HexabitzPlatform/H09R0x-Hardware/README.md

# H09R0x-Hardware
Hexabitz Thermocouple Sensor Module Hardware Design
