HexabitzPlatform/H09R0x-Hardware/Released/3D Models/691311500102/691311500102 (rev1).stp

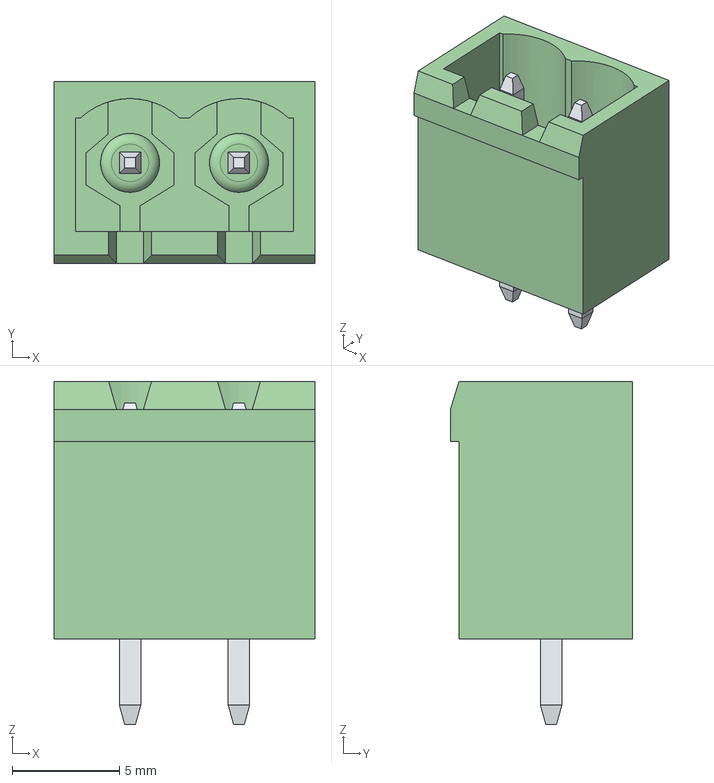
[picture p1: CAD file, 2019-05-23]
Released/3D Models/691311500102/691311500102 (rev1).stp
12.2 x 8.50 x 16.0 mm
6913115001xx_PIN x 2
