HexabitzPlatform/H09R0x-Hardware/Documentation/H09R01 Schematics.pdf

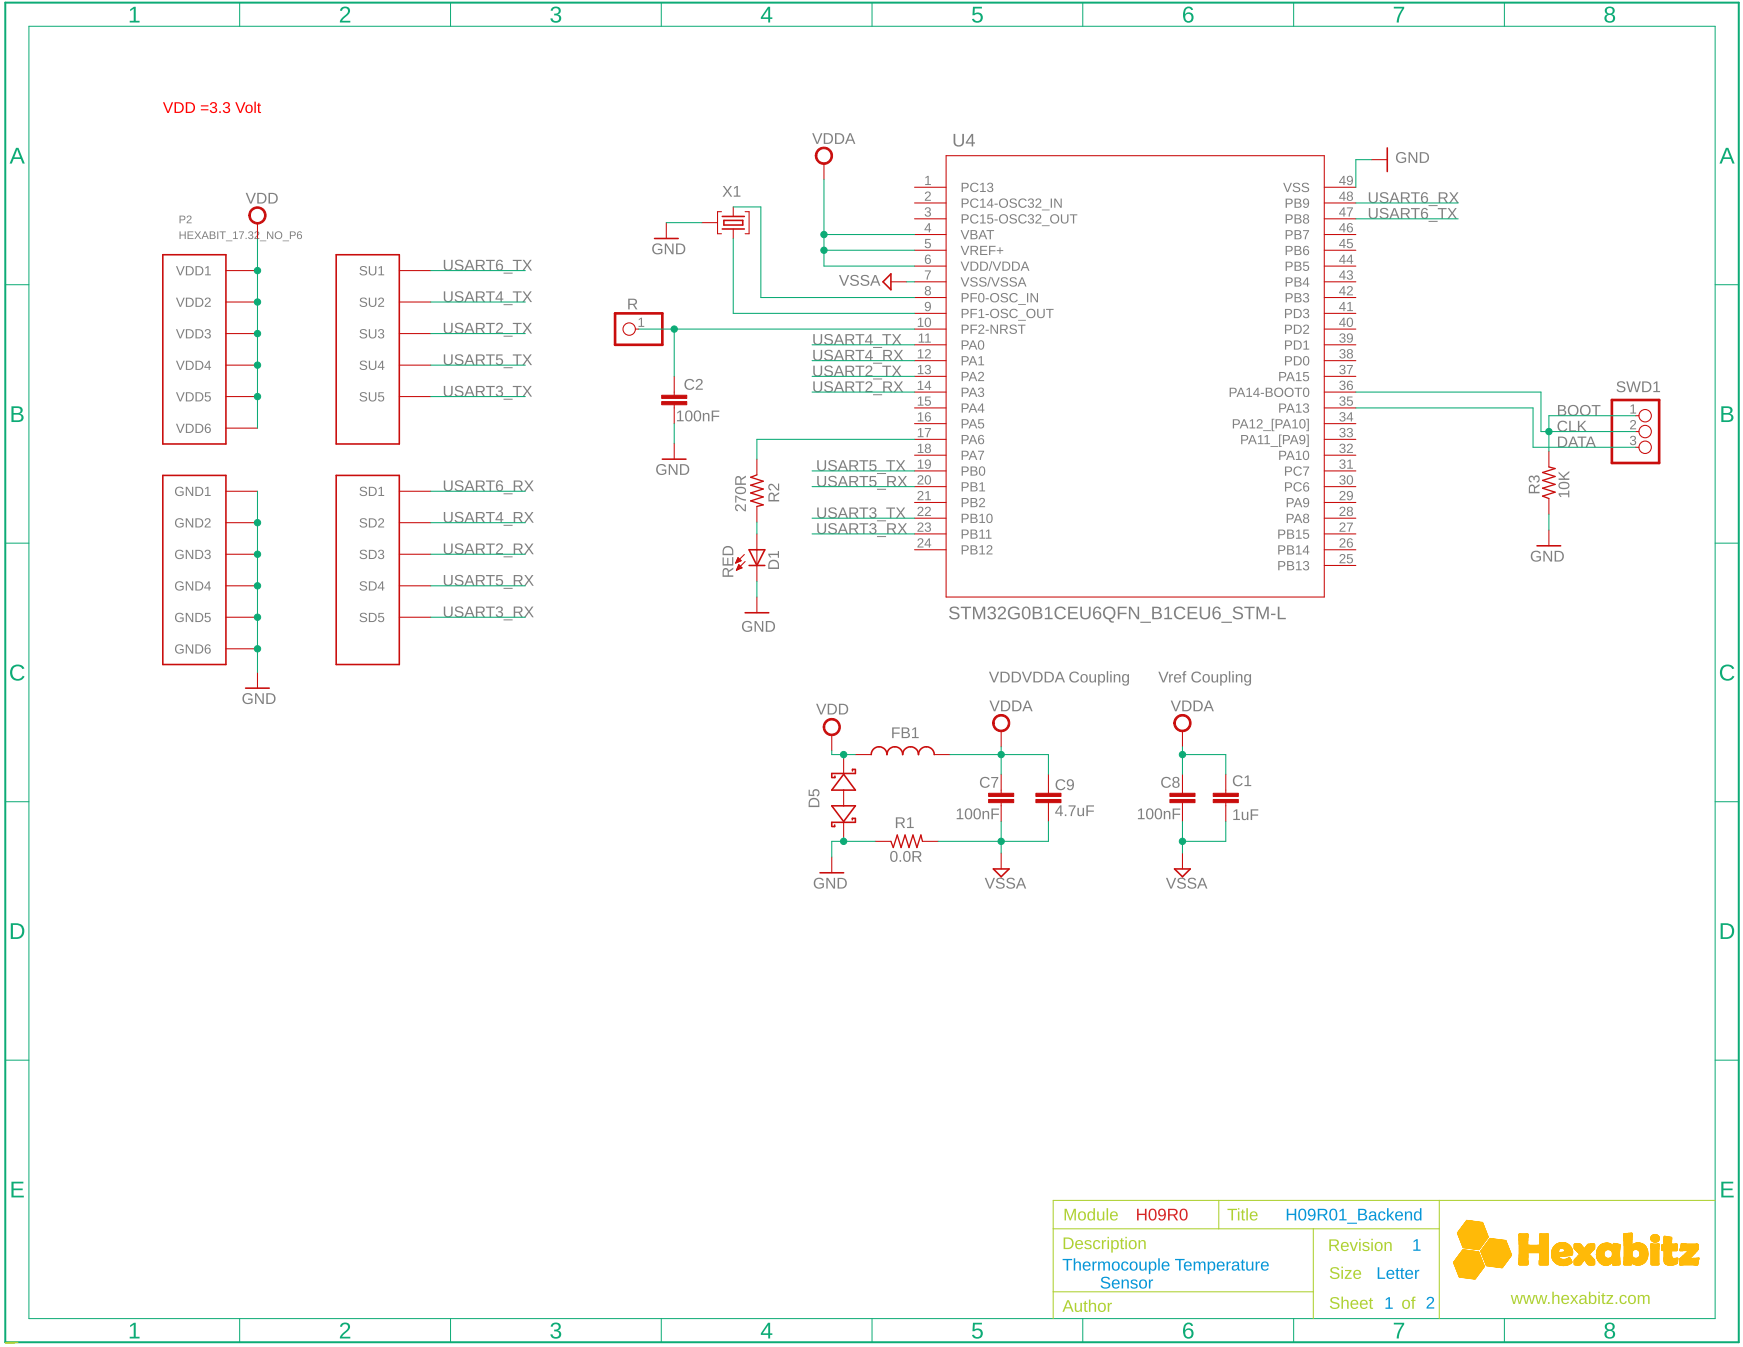
[picture p2: page 1]

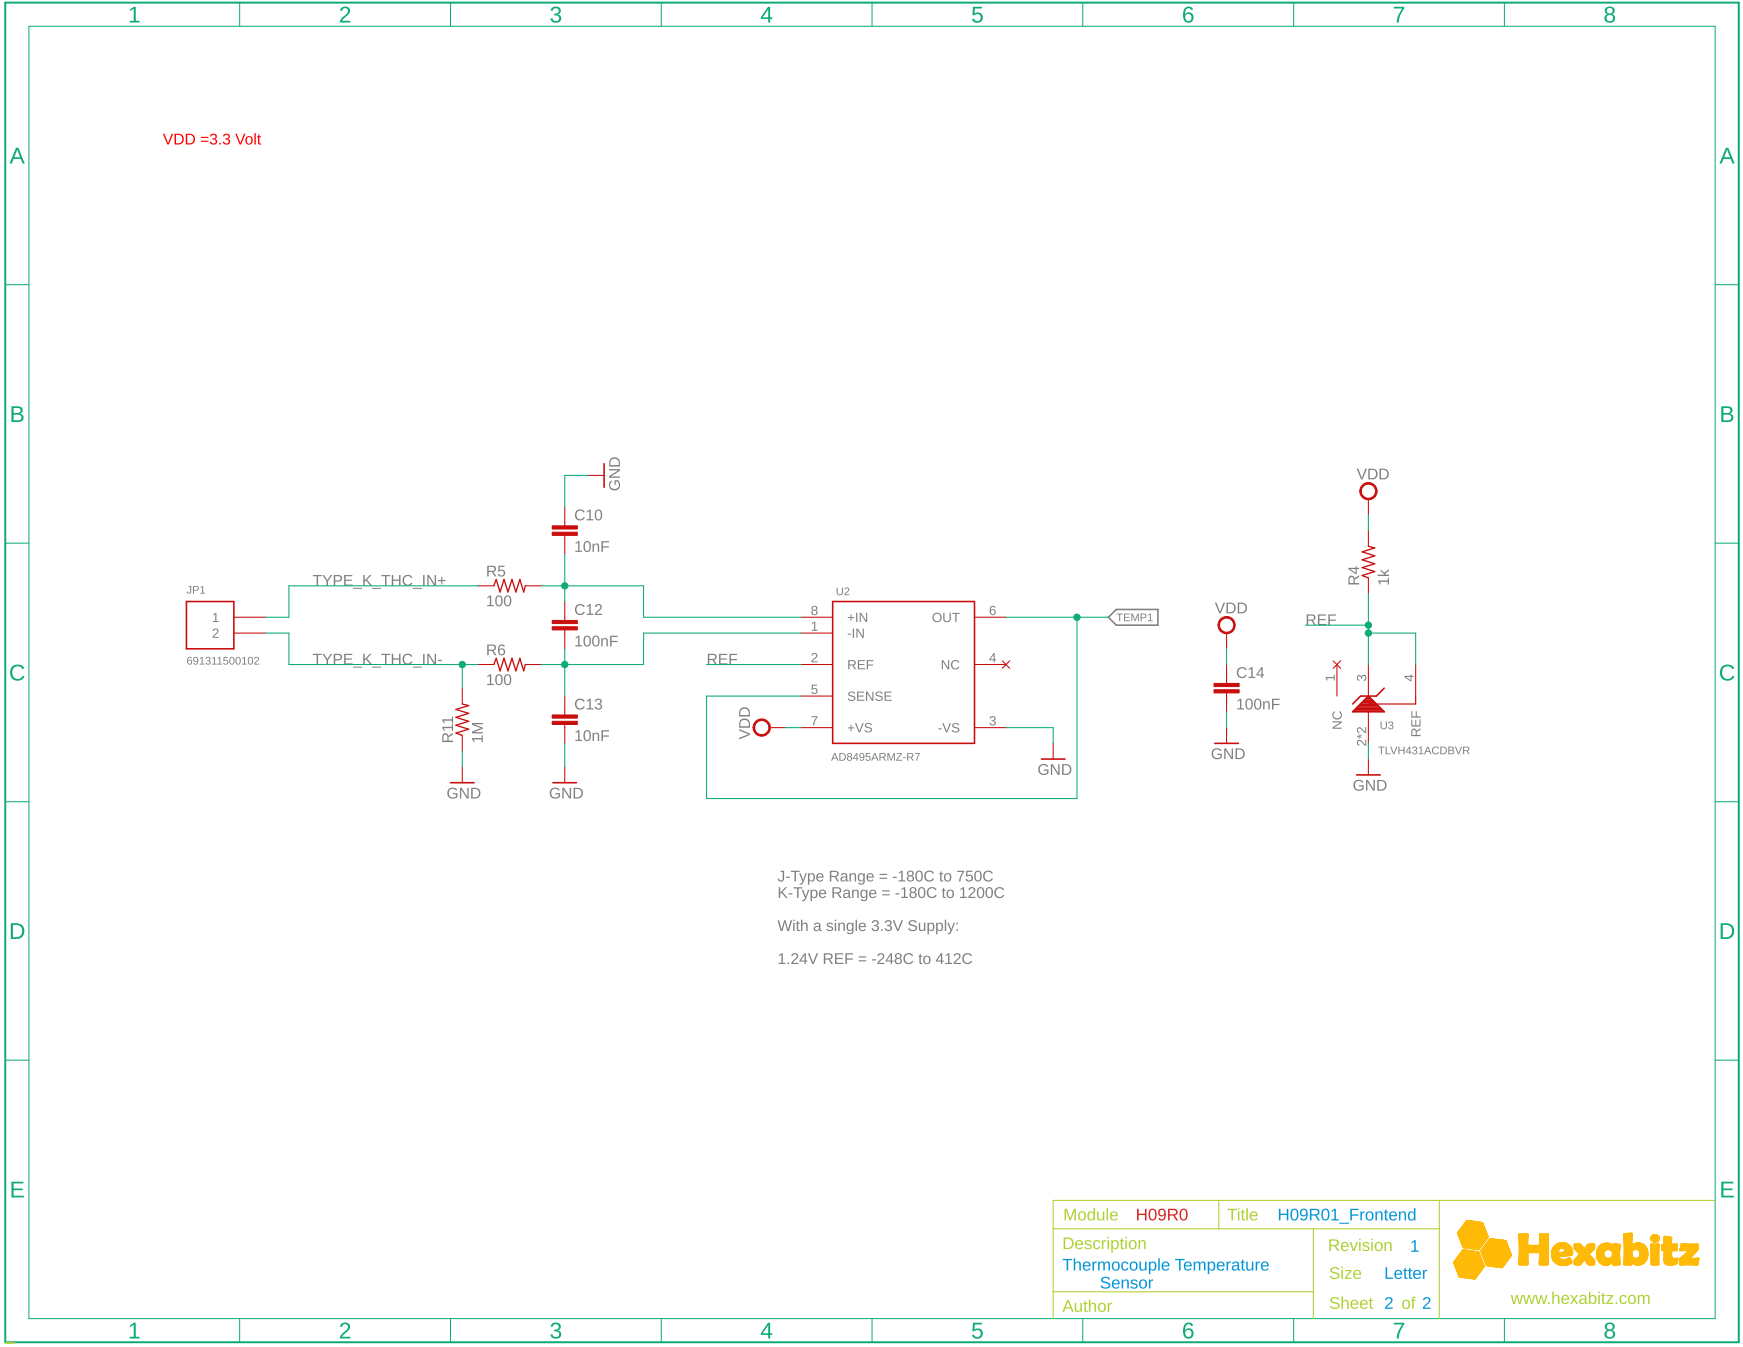
[picture p3: page 2]
