HexabitzPlatform/H09R0x-Hardware/Design/H09R0.brd

## EAGLE design Design/H09R0.brd (2024-12-14)

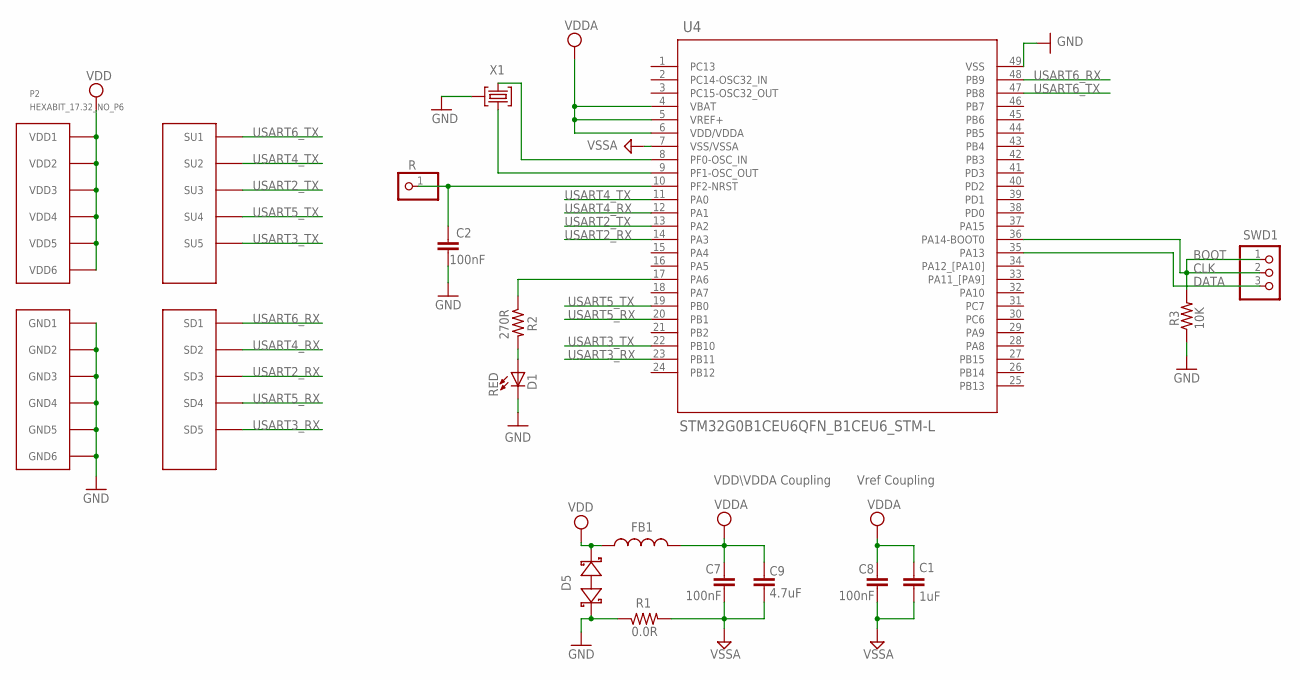
[picture p4: schematic H09R0.sch, sheet 1]

Parts:
C1: 1uF; C-0805
C2, C7, C8: 100nF; C-0603
C9: 4.7uF; C-0805
D1: RED; VLMS1300-GS08; MPN VLMS1300-GS08
D5: BOURNS_CDSOD323-T03SCBOURNS_CDSOD323-T03SC_0_0; BOURNS_CDSOD323-T03SC_0
FB1: FB-TDK_MMZ1608Y300B; FB-0603; MPN MMZ1608Y300B
P2: HEXABIT_17.32_NO_P6
R: R; 1X01
R1: 0.0R; R-0603; MPN RC0603JR-070RL
R2: 270R; R-0603
R3: 10K; R-0603
SWD1: PINHD-1X3; 1X03
U4: STM32G0B1CEU6QFN_B1CEU6_STM-L; QFN_B1CEU6_STM-L
X1: XTALL_CSTCE8M00G52

Connections:
CLK: R3.2, SWD1.1, SWD1.2, U4.36 (PA14-BOOT0)
DATA: SWD1.3, U4.35 (PA13)
GND: C2.2, D1.C, D5.1 (A), P2.PAD_PD7 (GND1), P2.PAD_PD8 (GND2), P2.PAD_PD9 (GND3), P2.PAD_PD10 (GND4), P2.PAD_PD11 (GND5), P2.PAD_PD12 (GND6), R1.1, R3.1, U4.49 (VSS), X1.P$2 (2); also elsewhere on the board
unnamed: U4.9 (PF1-OSC_OUT), X1.P$1 (1)
unnamed: U4.8 (PF0-OSC_IN), X1.P$3 (3)
unnamed: C2.1, R.1, U4.10 (PF2-NRST)
unnamed: R2.1, U4.17 (PA6)
unnamed: D1.A, R2.2
USART2_RX: P2.PAD_PD3 (SD3), U4.14 (PA3)
USART2_TX: P2.PAD_PU3 (SU3), U4.13 (PA2)
USART3_RX: P2.PAD_PD5 (SD5), U4.23 (PB11)
USART3_TX: P2.PAD_PU5 (SU5), U4.22 (PB10)
USART4_RX: P2.PAD_PD2 (SD2), U4.12 (PA1)
USART4_TX: P2.PAD_PU2 (SU2), U4.11 (PA0)
USART5_RX: P2.PAD_PD4 (SD4), U4.20 (PB1)
USART5_TX: P2.PAD_PU4 (SU4), U4.19 (PB0)
USART6_RX: P2.PAD_PD1 (SD1), U4.48 (PB9)
USART6_TX: P2.PAD_PU1 (SU1), U4.47 (PB8)
VDD: D5.2 (C), FB1.2, P2.PAD_PU7 (VDD1), P2.PAD_PU8 (VDD2), P2.PAD_PU9 (VDD3), P2.PAD_PU10 (VDD4), P2.PAD_PU11 (VDD5), P2.PAD_PU12 (VDD6); also elsewhere on the board
VDDA: C1.1, C7.1, C8.1, C9.1, FB1.1, U4.4 (VBAT), U4.5 (VREF+), U4.6 (VDD/VDDA)
VSSA: C1.2, C7.2, C8.2, C9.2, R1.2, U4.7 (VSS/VSSA)

Notes on the sheet:
Vref Coupling
VDD\VDDA Coupling
BOOT

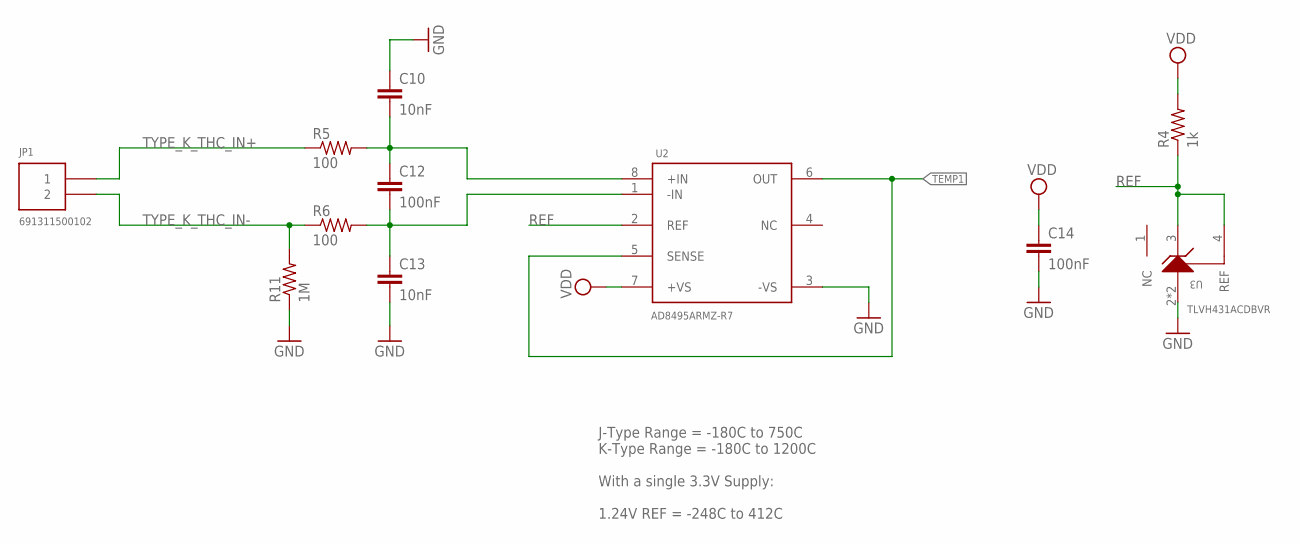
[picture p5: schematic H09R0.sch, sheet 2]

Parts:
C10, C13: 10nF; C-0603; TOLERANCE 10%; VOLTAGE_RATING 50V; MPN C0603C103K5RACTU
C12, C14: 100nF; C-0603; TOLERANCE 10%; VOLTAGE_RATING 10V; MPN C0603C104K8RACTU
JP1: 691311500102; 1546111-2
R4: 1k; R-0402; TOLERANCE 1%; MPN RC0402FR-071KL
R5, R6: 100; R-0402; TOLERANCE 1%; MPN RC0402FR-07100RL
R11: 1M; R-0402; TOLERANCE 1%; MPN RC0402FR-071ML
U2: AD8495ARMZ-R7; AD8495ARMZ
U3: TLVH431ACDBVR

Connections:
GND: C10.1, C13.2, C14.2, R11.1, U2.3 (-VS), U3.2 (ANODE), U3.5 (ANODE); also elsewhere on the board
unnamed: C10.2, C12.1, R5.2, U2.8 (+IN)
unnamed: C12.2, C13.1, R6.2, U2.1 (-IN)
REF: R4.1, U2.2 (REF), U3.3 (CATHODE), U3.4 (REF)
TEMP1: U2.5 (SENSE), U2.6 (OUT)
TYPE_K_THC_IN+: JP1.1, R5.1
TYPE_K_THC_IN-: JP1.2, R6.1, R11.2
VDD: C14.1, R4.2, U2.7 (+VS); also elsewhere on the board

Notes on the sheet:
J-Type Range = -180C to 750C K-Type Range = -180C to 1200C With a single 3.3V Supply: 1.24V REF = -248C to 412C

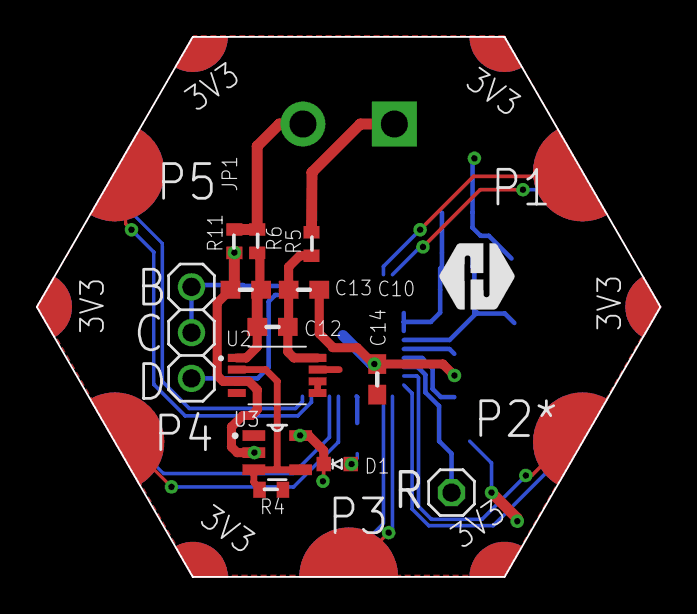
[picture p6: board H09R0.brd from above]

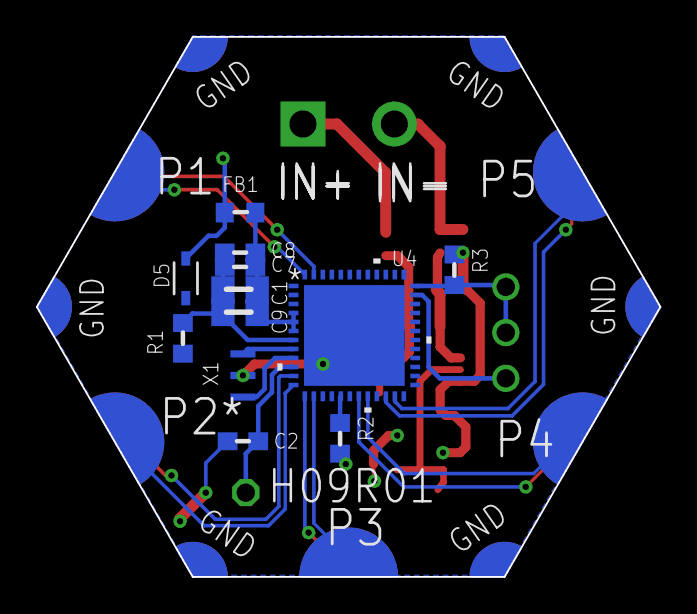
[picture p7: board H09R0.brd from below]

Board: 2 copper layers, 34.6 x 30.0 mm, 28 parts (12 on the bottom side), 27 nets.

Other parts of the board:
U$1: HEXA-LOGO
