HexabitzPlatform/H09R0x-Hardware/(commit log)

2019-05-23 First release rev 0
    [691311500102 (rev1).stp, H09R00.brd, H09R00.sch, H09R00.xlsx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]
2019-08-13 Fix schematics PDF colors
2024-01-02 -Standarize the files and folders
    [691311500102 (rev1).stp, H09R0.brd, H09R0.sch, H09R0.xlsx, H09R00.sch, H09R00.xlsx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]
2024-12-12 - Deleted old output files - Changed MCU to G0 - New schematic - New layout - Generated documentation - Generated BOM
    [H09R0.brd, H09R0.sch, H09R0.xlsx, H09R01.xlsx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]
2024-12-14 - Deleted yellow and orange LEDs from design - Changed connector - Changed RESs and CAPs and used from our library - New layout - Changed polygon to thermal - Rearranged compenents in BOM
    [H09R0.brd, H09R0.sch, H09R01.xlsx]
2024-12-14 - Rearranged components in BOM
    [H09R01.xlsx]
2024-12-14 - Changed logo in layout - Rearranged components in BOM
    [H09R0.brd, H09R01.xlsx]
